hapcan/UNIV_3.2.3.x/Hardware_UNIV_3.2.3.x/univ_3-2-3-x-label.docx

K1 | K2 | K3 | K4 | K5 | K6

MONOSTABLE RELAY

6 CHANNEL

IN = 16A (IINRUSH = 30A)

UN = 250V AC
TYPE | UNIV 3.2.3.x
S/N | 00000569h
BUS BUS | | | hapcan.com

K1 | K2 | K3 | K4 | K5 | K6

PRZEKAŹNIK MONOSTABILNY

6 KANAŁOWY

IN = 16A (IROZRUCHOWY = 30A)

UN = 250V AC
TYP | UNIV 3.2.3.x
S/N | 00000569h
BUS BUS | | | hapcan.com
