hapcan/UNIV_3.2.3.x/(commit log)

2013-09-25 revision 0
    [univ_3-2-3-0-rev0-memory.xlsx]
2013-09-25 revision 1
    [univ_3-2-3-0-rev1-memory.xlsx]
2013-09-25 hardware revision 1
    [pcb_univ_3-2-(3-4)-x-rev1.brd, pcb_univ_3-2-(3-4)-x-rev1.sch, univ_3-2-3-x-rev1.sch]
2016-02-11 firmware UNIV 3.2.3.0 revision 2
    [univ_3-2-3-0-rev2-memory.xlsx]
2016-03-19 hardware UNIV 3.2.3.x revision 1
    [pcb_univ_3-2-(3-4)-x-rev1.brd, pcb_univ_3-2-(3-4)-x-rev1.sch, univ_3-2-3-x-rev1.sch]
2016-03-19 hardware UNIV 3.2.3.x revision 2
    [pcb_univ_3-2-(3-4)-x-rev2.brd, pcb_univ_3-2-(3-4)-x-rev2.sch, univ_3-2-3-x-rev2.sch]
2022-10-31 firmware UNIV 3.2.3.0 revision 3
    [univ_3-2-3-0-rev3-memory.xlsx]
